Jopolle/INZYNIERKA/README.md

# Repozytorium projektu inżynierskiego

W repozytorium znajdują się wszystkie istotne pliki dotyczące projektu

- Folder HVAC_STM32F7_PCB zawiera schematy projektowanego PCB jak i projekt samej płytki

- Folder dokumentacja zawiera pliki LaTeX pracy inżynierskiej i ostatnią skompilowaną wersję
