Jopolle/INZYNIERKA/dokumentacja/abstract.tex

\begin{abstract}
Praca przedstawia projekt oraz weryfikację stanowiska pomiarowego dla wybranych wielkości fizycznych typowych w systemach HVAC (temperatura, wilgotność, ciśnienie, przepływ oraz sygnały sterujące \SI{0}-\SI{10}{\volt}). Rozwiązanie bazuje na zestawie uruchomieniowym STM32F746G-Discovery z wyświetlaczem TFT oraz na dedykowanej karcie pomiarowo–wyjściowej \SI{0}-\SI{10}{\volt} zaprojektowanej w KiCad. Oprogramowanie wykonano w środowisku Zephyr RTOS z wykorzystaniem sterowników peryferiów i biblioteki LVGL do obsługi interfejsu graficznego.
Przedstawiono wymagania funkcjonalne, projekt części analogowej (tory wejściowe z ochroną i skalowaniem, tor wyjściowy \SI{0}-\SI{10}{\volt}), architekturę oprogramowania (wątki RTOS, kolejki, sterowniki), a także wyniki walidacji dokładności i powtarzalności pomiarów na podstawie wzorców i porównania z przyrządami referencyjnymi. 
\end{abstract}
