Jopolle/INZYNIERKA/dokumentacja/main.tex

\documentclass{pginz}

%%%%%%%%%Miejsce na dodatkowe pakiety%%%%%%%%%%%%%
\usepackage{csquotes}
\usepackage[backend=bibtex,style=numeric,sortcites,sorting=nty,backref,natbib,hyperref]{biblatex}

%\documentclass[a4paper,12pt]{article}

% % Polski język i kodowanie
% \usepackage[utf8]{inputenc}
% \usepackage[T1]{fontenc}
% \usepackage[polish]{babel}

% % Podstawowe pakiety
% \usepackage{amsmath, amssymb}
% \usepackage{graphicx}
% \usepackage{hyperref}
% \usepackage{lmodern}
% \usepackage{csquotes}
% \usepackage{siunitx}
% \DeclareSIUnit{\pixel}{px}
% \usepackage{microtype}
% \usepackage{graphicx}
% \usepackage{float}
% \usepackage{booktabs}
% \usepackage{hyperref}
% \usepackage{geometry}
% \geometry{margin=2.5cm}
% \usepackage[backend=bibtex,style=numeric,sortcites,sorting=nty,backref,natbib,hyperref]{biblatex}

\addbibresource{bibliografia.bib}

\usepackage{minted}
\usepackage{longtable}

\title{Projekt stanowiska pomiarowego podstawowych wielkości fizycznych wykorzystywanych w systemach HVAC
\\\large w oparciu o zestaw STM32F746G-Discovery z wyświetlaczem TFT}
\author{Paweł Bałbatun}
\date{\today}

\begin{document}

\includepdf[pages=-]{StronaTytulowa_193652.pdf}
\tableofcontents

\input{abstract}

\input{intro}
\input{state_of_art}
\input{requirements}
\input{hardware}
\input{firmware}
\input{validation}

\printbibliography
\end{document}
