Jopolle/INZYNIERKA/StronaTytulowa_193652 (1).pdf

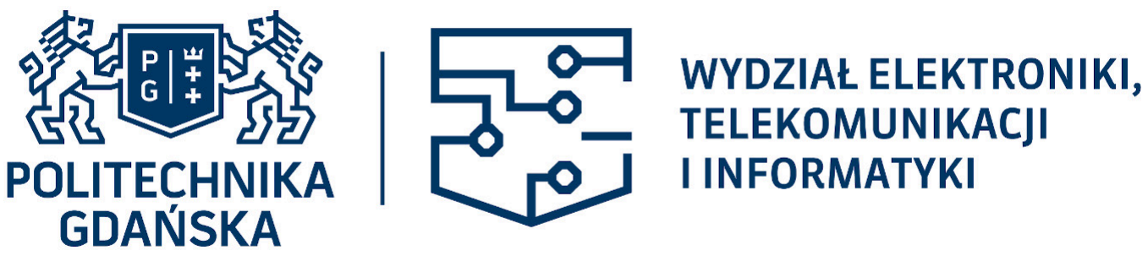
[picture p18: figure]

Imię i nazwisko studenta: Paweł Bałbatun
Nr albumu: 193652
Poziom kształcenia: studia pierwszego stopnia
Forma studiów: stacjonarne
Kierunek studiów: Automatyka, cybernetyka i robotyka Profil: Systemy automatyki

### PROJEKT DYPLOMOWY INŻYNIERSKI

Tytuł projektu w języku polskim: Projekt stanowiska pomiarowego podstawowych wielkości fizycznych wykorzystywanych w systemach HVAC w oparciu o wybrany zestaw uruchomieniowy wyposażony w wyświetlacz graficzny TFT

Tytuł projektu w języku angielskim: Design of a measurement card for a laboratory stand for measuring physical quantities in HVAC systems, based on a selected design kit with a TFT graphic display.

Opiekun pracy: mgr inż. Piotr Darski
