Jopolle/INZYNIERKA/dokumentacja/img/pcb/pcb_zasilanie.png

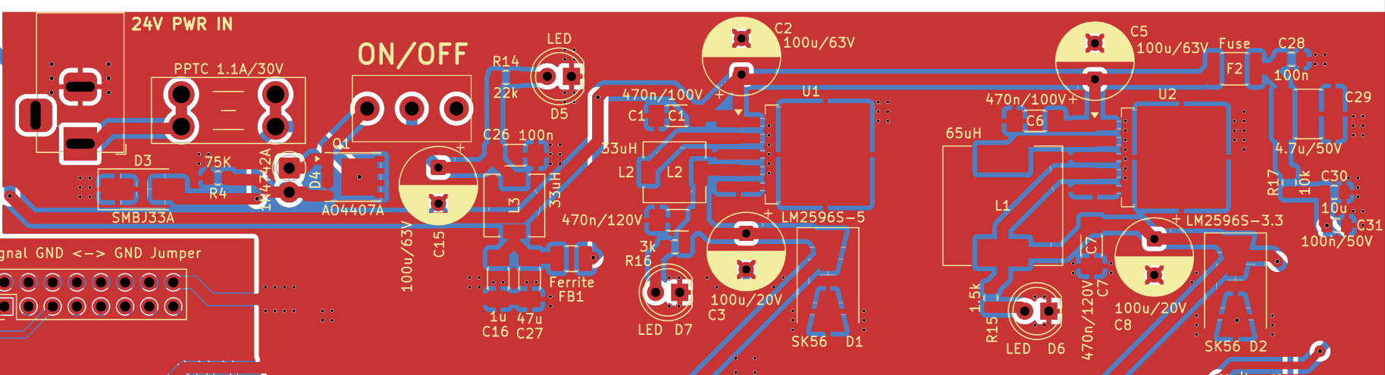
dokumentacja/img/pcb/pcb_zasilanie.png
