Jopolle/INZYNIERKA/dokumentacja/img/pcb/render_empty.png

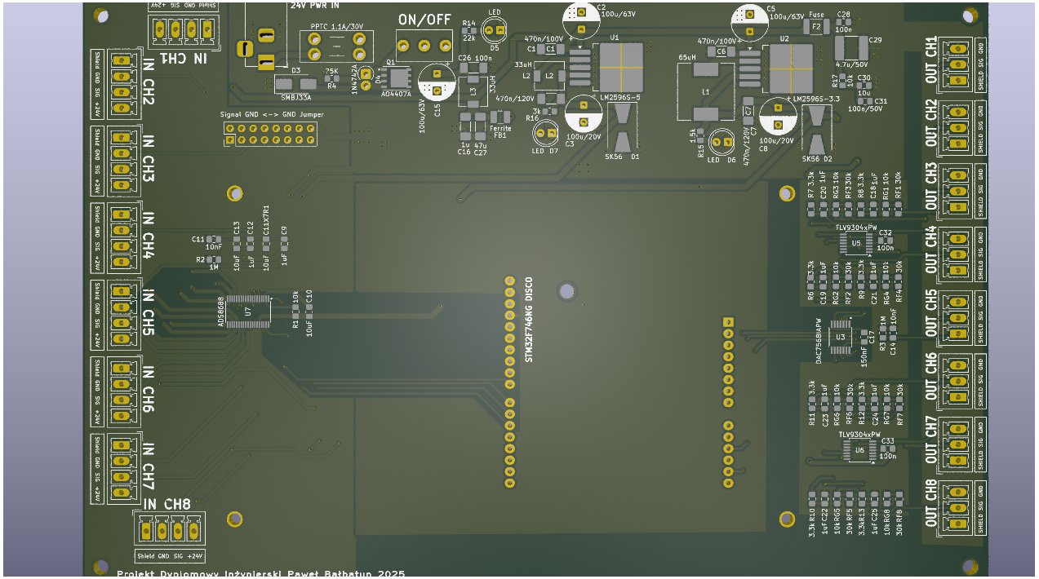
dokumentacja/img/pcb/render_empty.png
