Jopolle/INZYNIERKA/dokumentacja/img/pcb/render_full.png

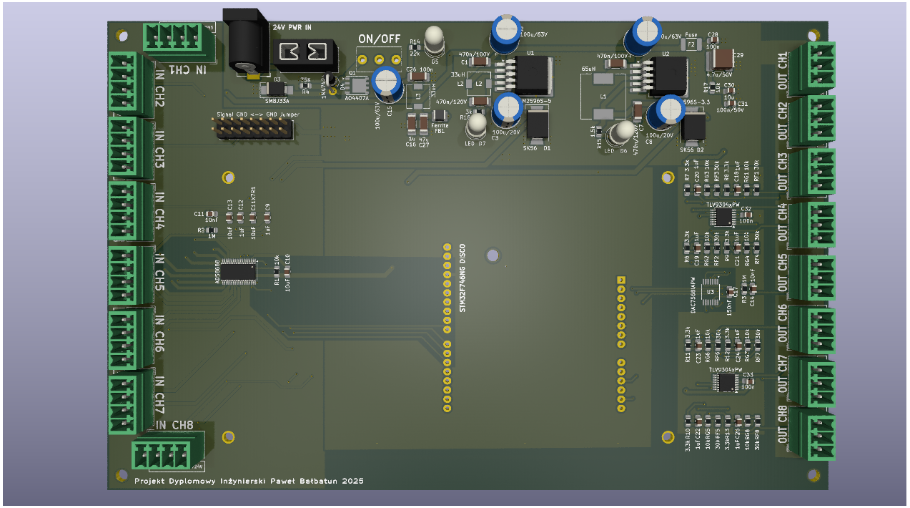
dokumentacja/img/pcb/render_full.png
