Jopolle/INZYNIERKA/HVAC_STM32F7_PCB/HVAC_STM32F7_PCB.jpg

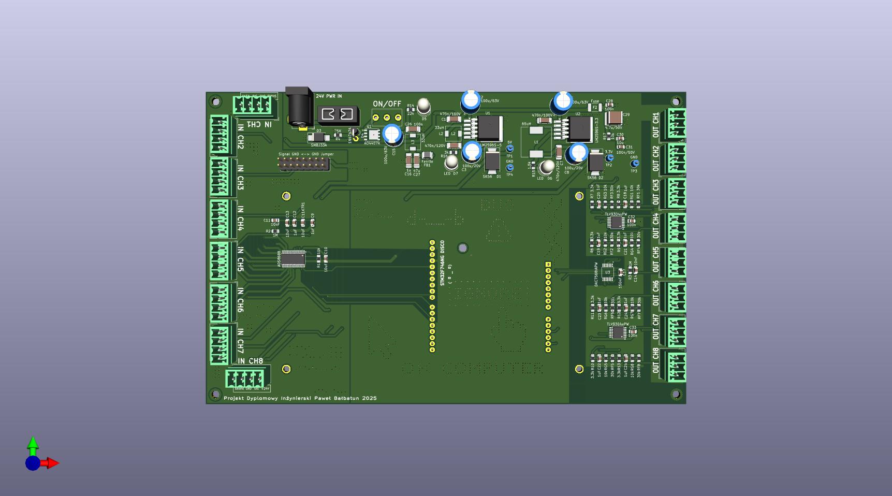
HVAC_STM32F7_PCB/HVAC_STM32F7_PCB.jpg
