Jopolle/INZYNIERKA/dokumentacja/validation.tex

\section{Walidacja}
\subsection{Metodyka}
Źródła wzorcowe (kalibrator napięcia), obciążenie dla wyjścia 0–10 V, środowisko testowe.

\subsection{Wyniki}
Tabele dokładności, histogram odchyleń, niepewność typu A/B, budżet niepewności.

\subsection{Dyskusja}
Ograniczenia, dryft temperaturowy, histereza, propozycje ulepszeń.
