Jopolle/INZYNIERKA/pcb.pdf

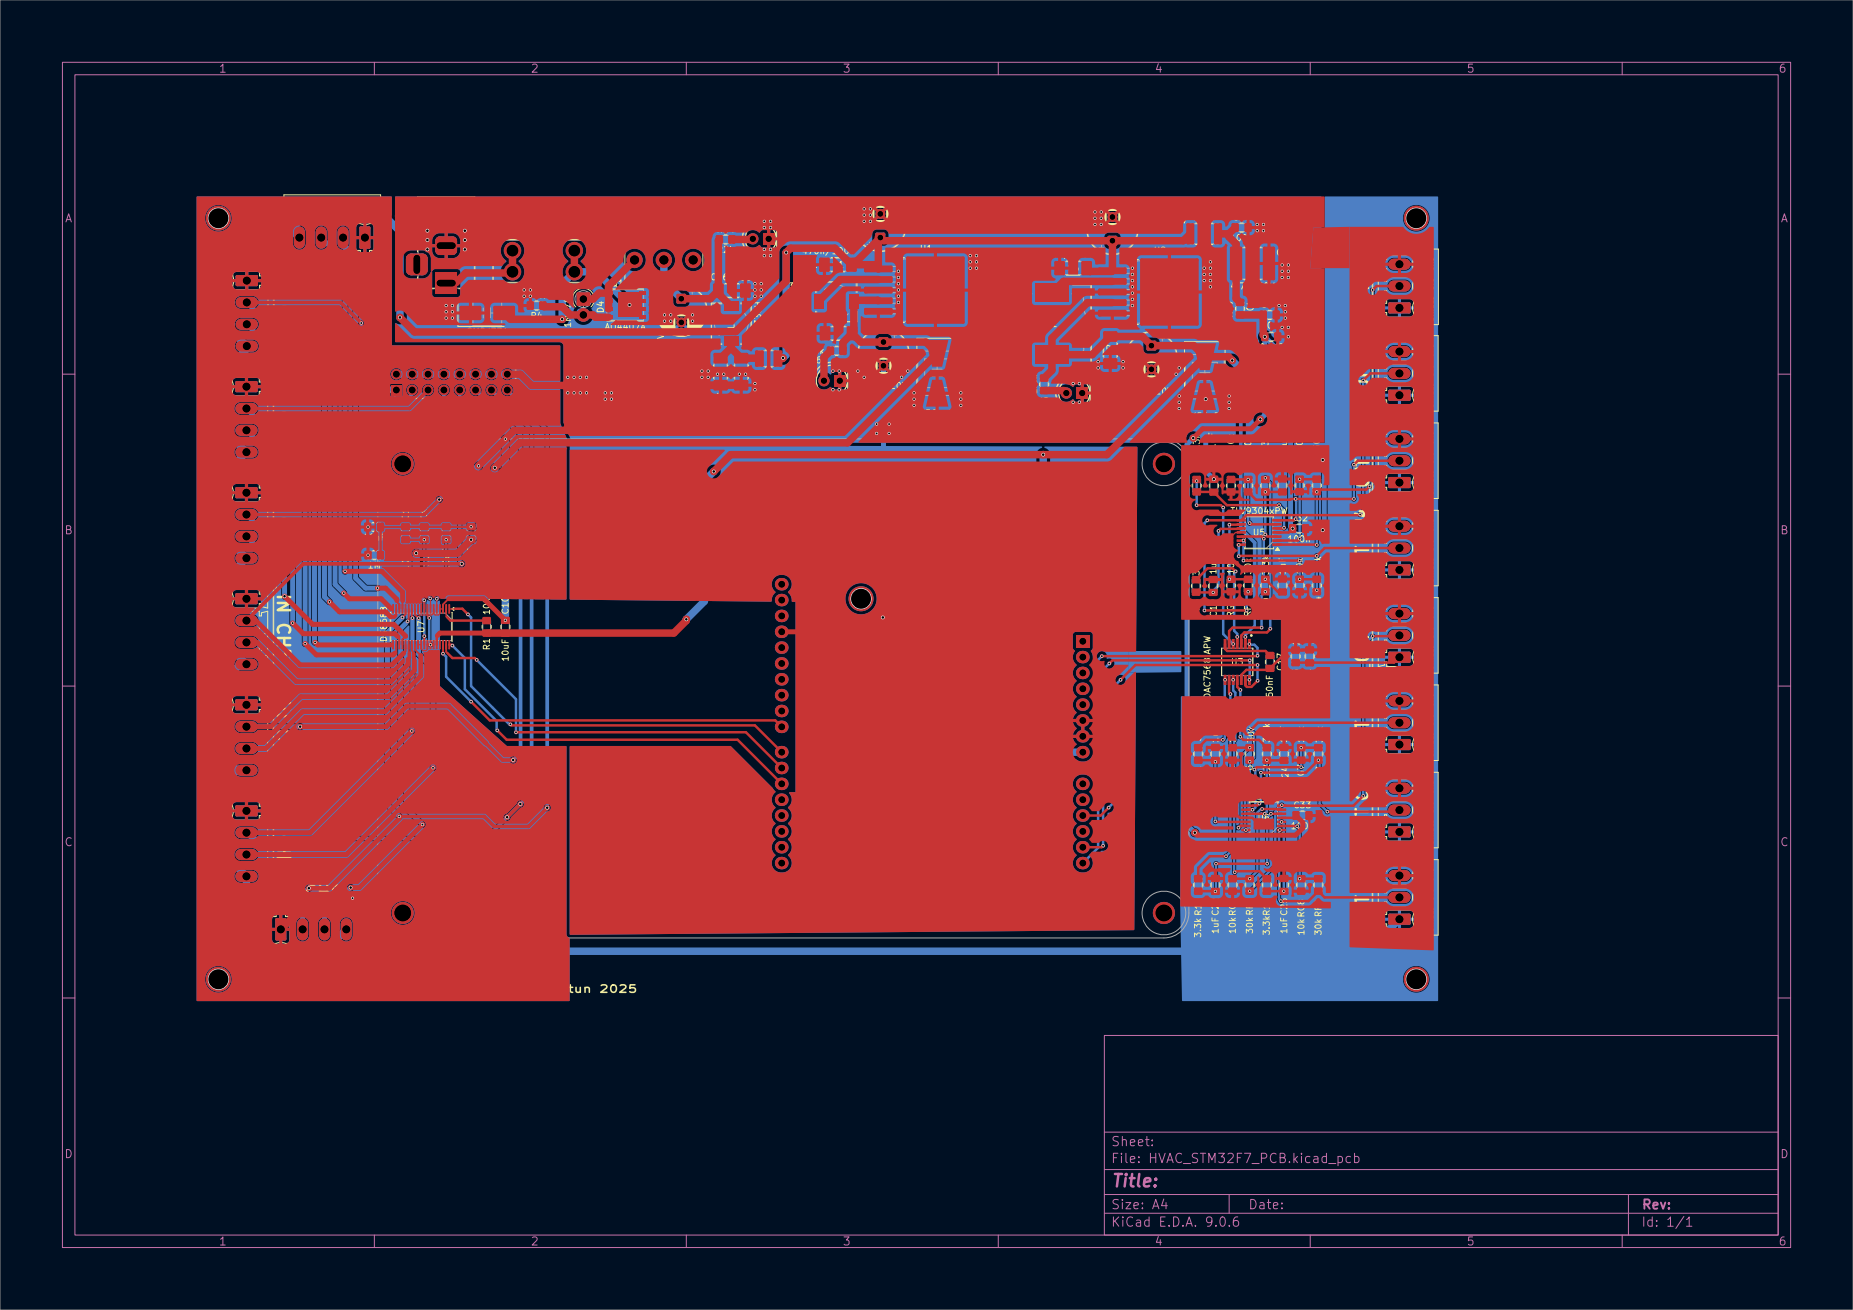
[picture p23: page 1]
