Jopolle/INZYNIERKA/FINALNY/karta_montażowa.pdf

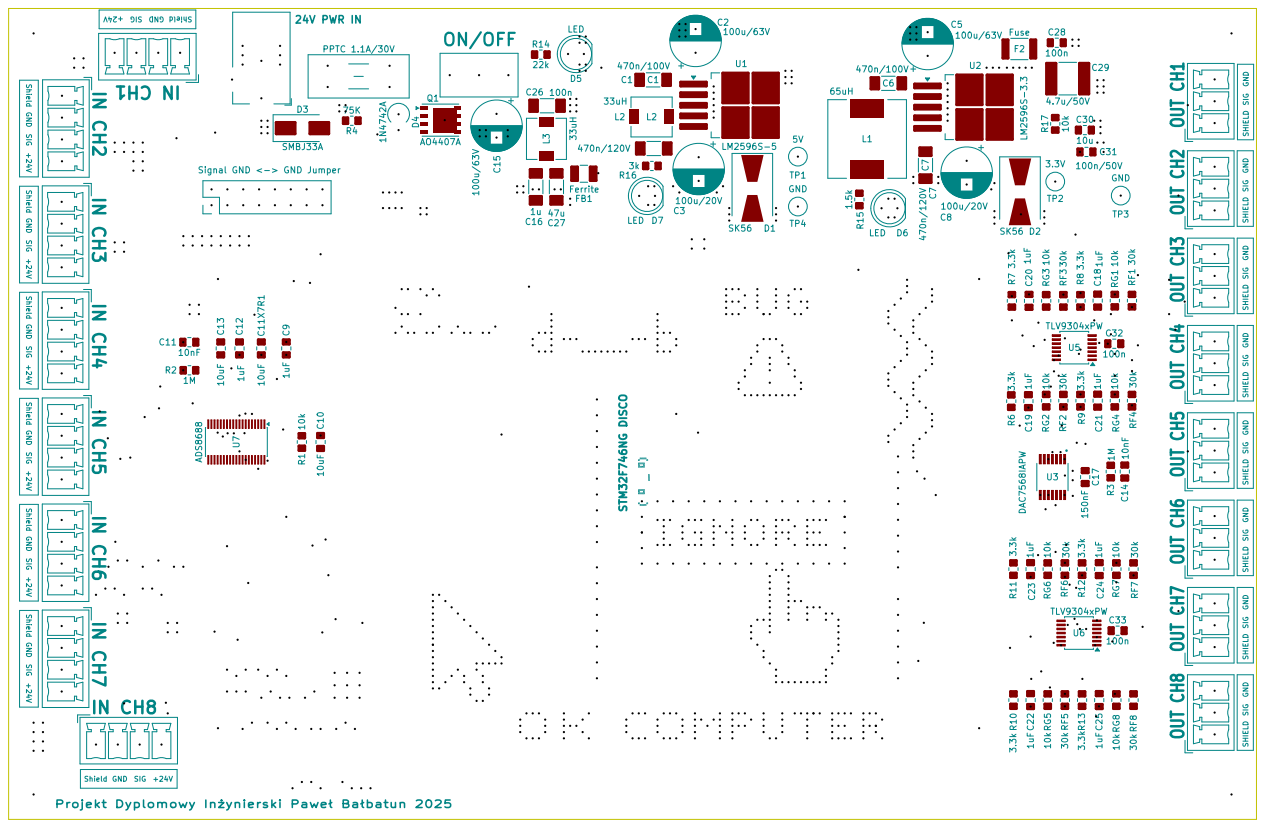
[picture p24: page 1]
