Jopolle/INZYNIERKA/dokumentacja/svg-inkscape/pcb_drawing_svg-raw.pdf

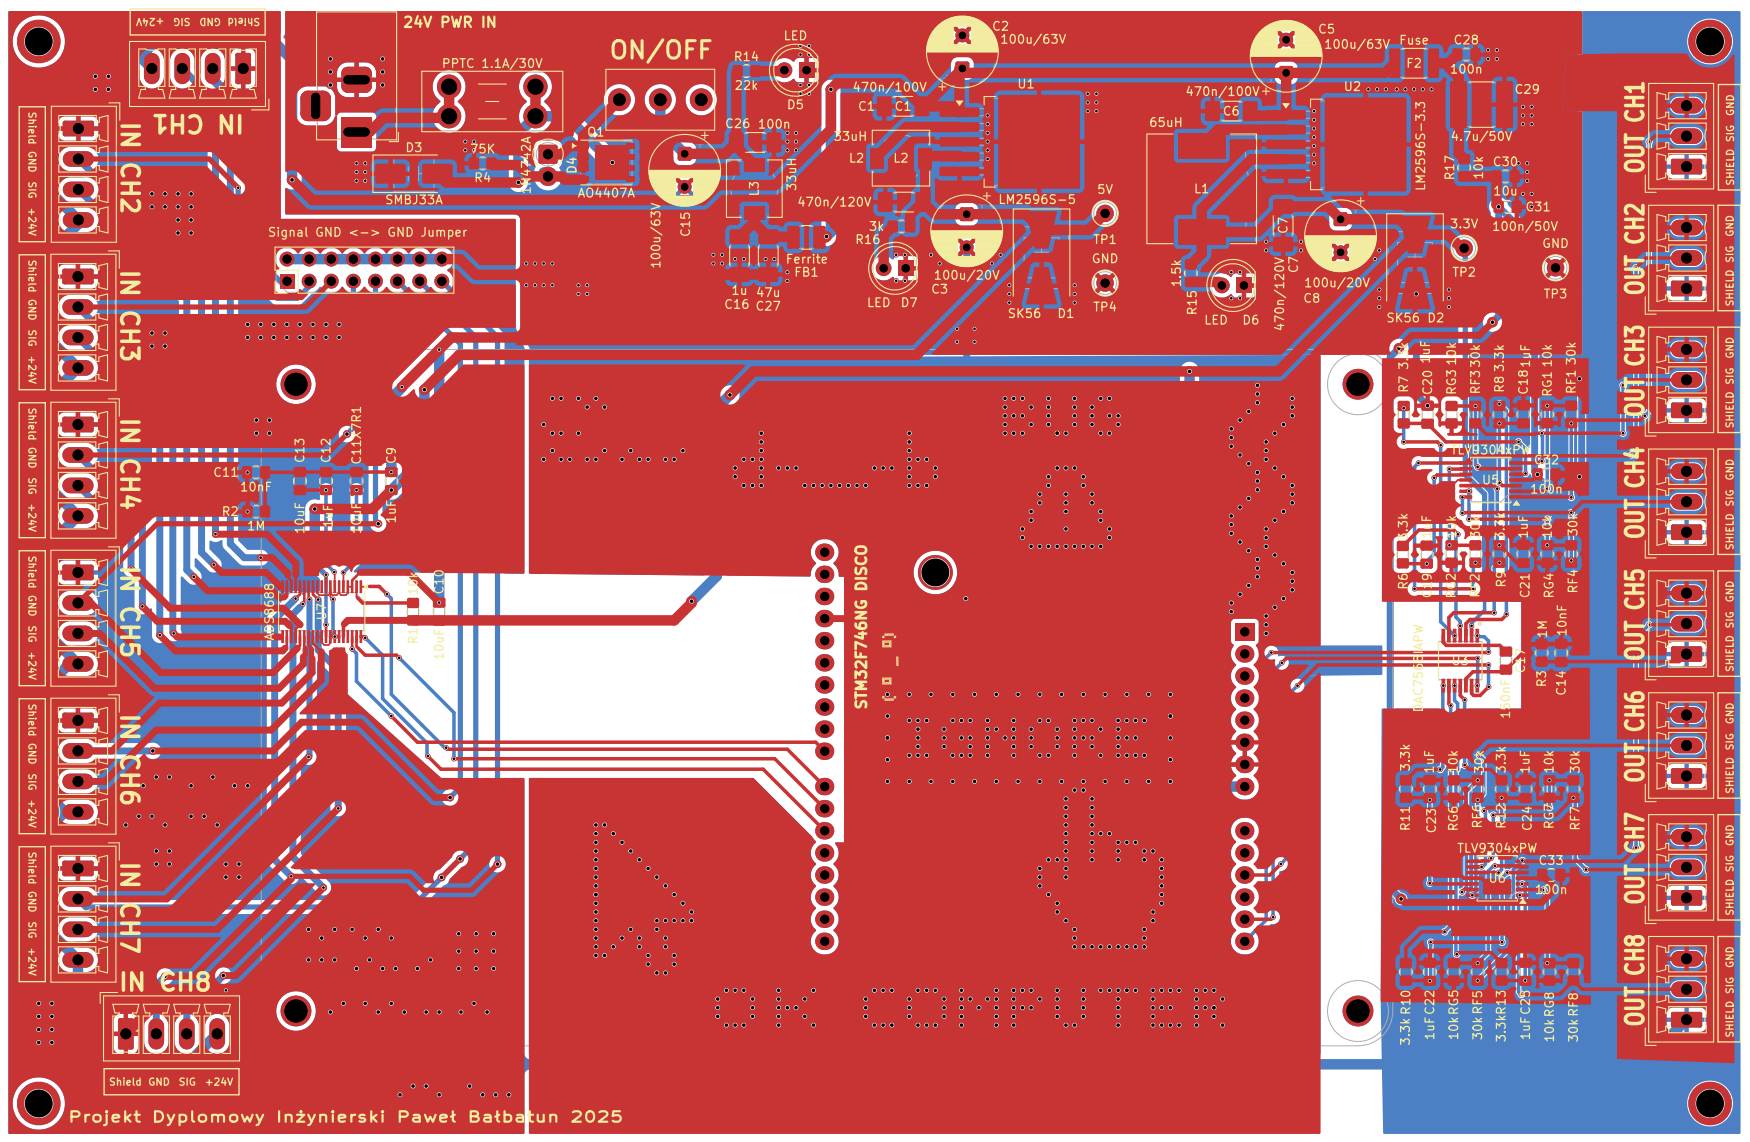
[picture p28: page 1]
