Jopolle/INZYNIERKA/dokumentacja/svg-inkscape/schemat_dac_svg-raw.pdf

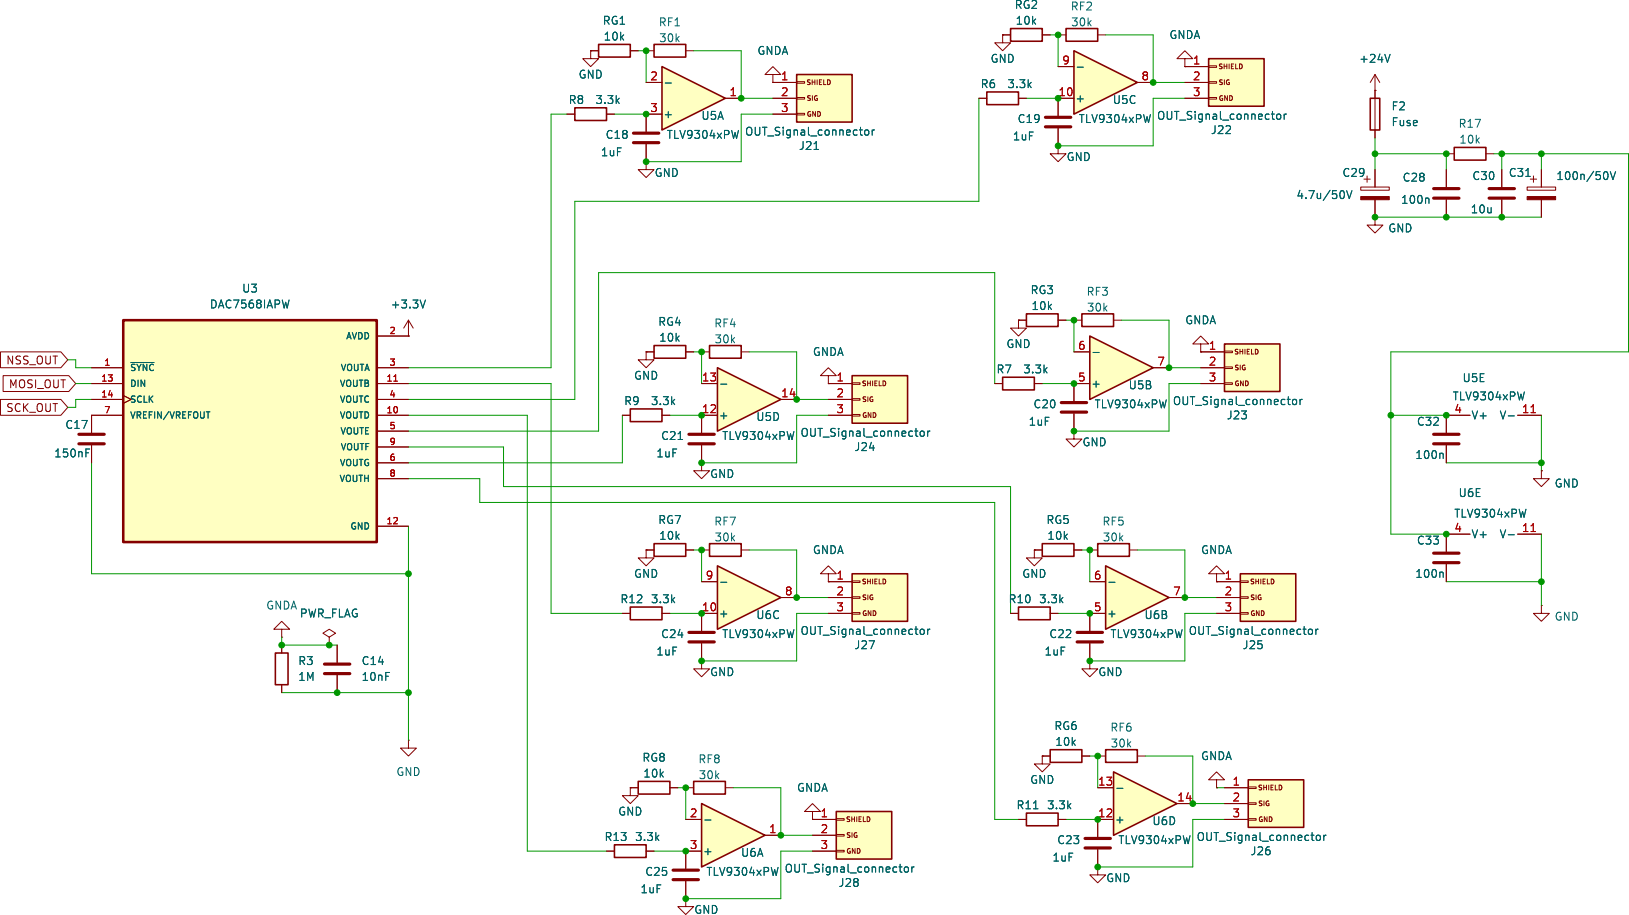
[picture p29: page 1]
