Jopolle/INZYNIERKA/dokumentacja/svg-inkscape/schemat_mcu_svg-raw.pdf

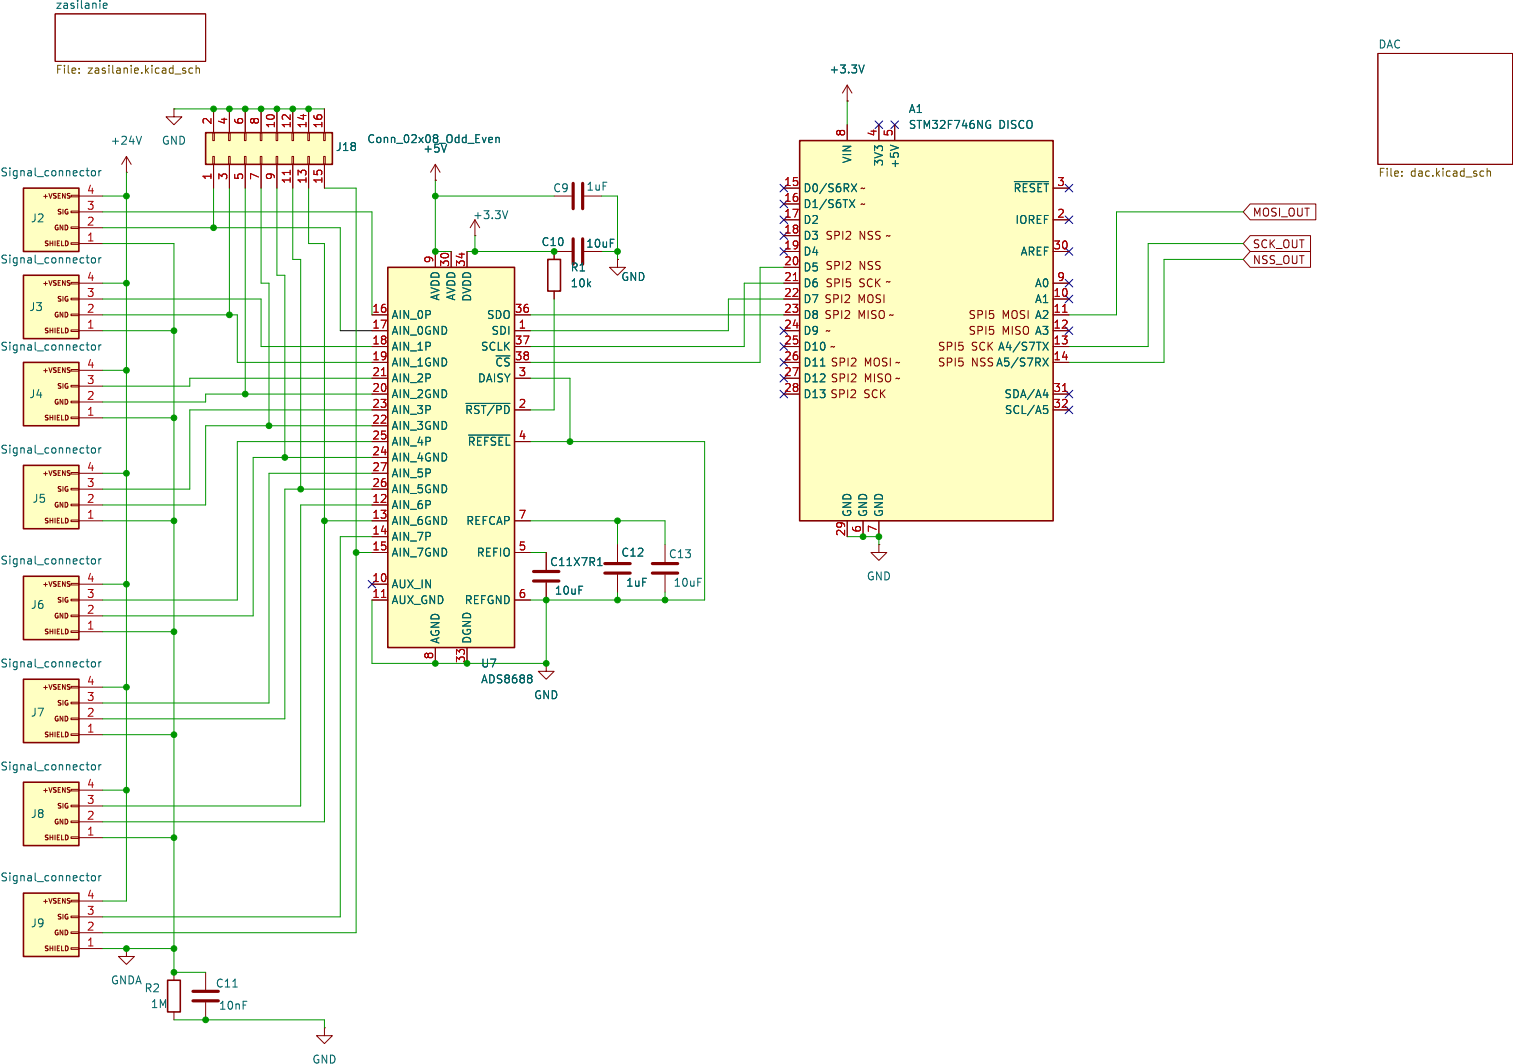
[picture p30: page 1]
