Jopolle/INZYNIERKA/dokumentacja/svg-inkscape/schemat_zasilanie_svg-raw.pdf

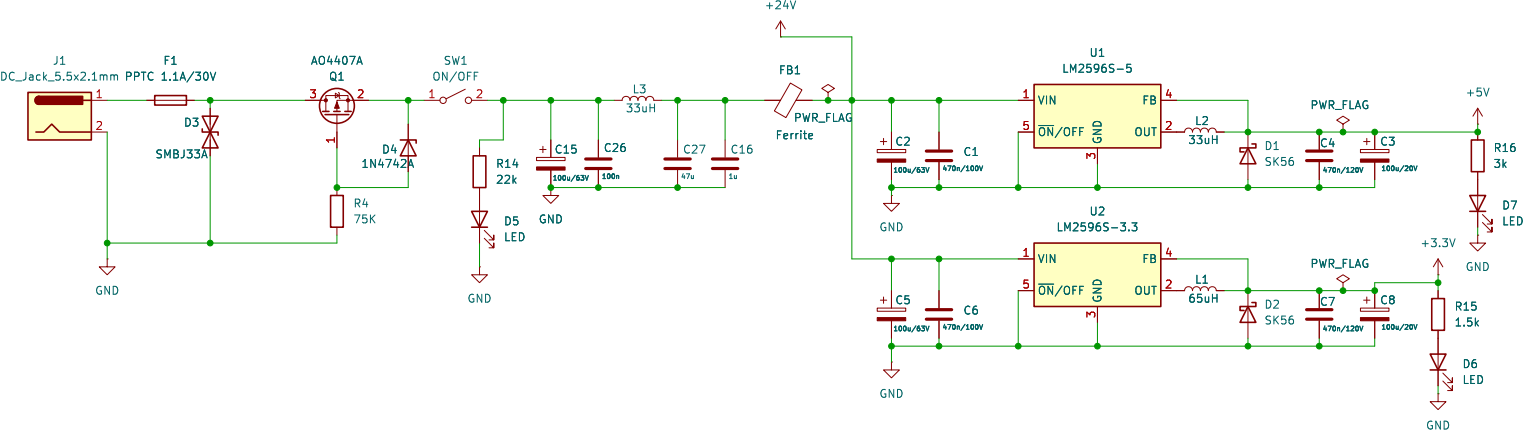
[picture p31: page 1]
