Jopolle/INZYNIERKA/dokumentacja/img/pcb/output.pdf

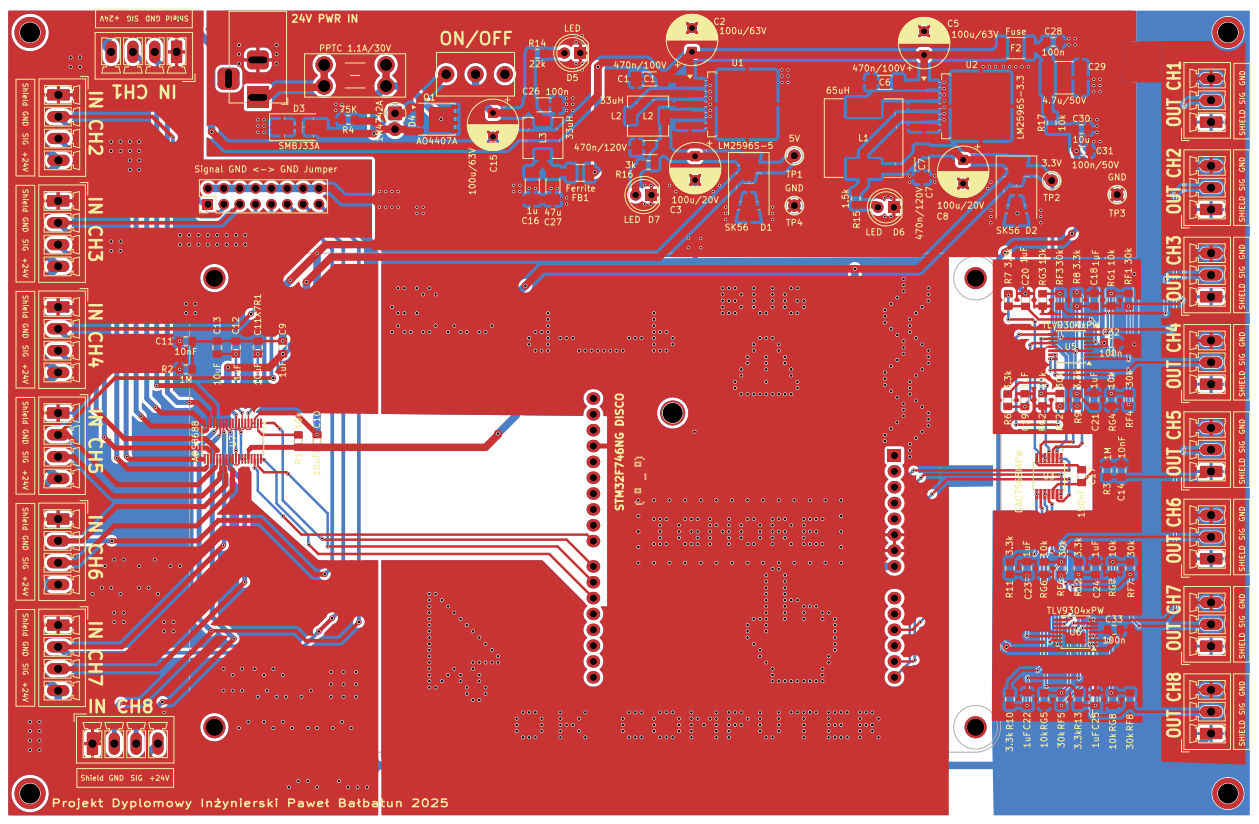
[picture p32: page 1]
