Jopolle/INZYNIERKA/dokumentacja/svg-inkscape_old/pcb_drawing_svg-raw.pdf

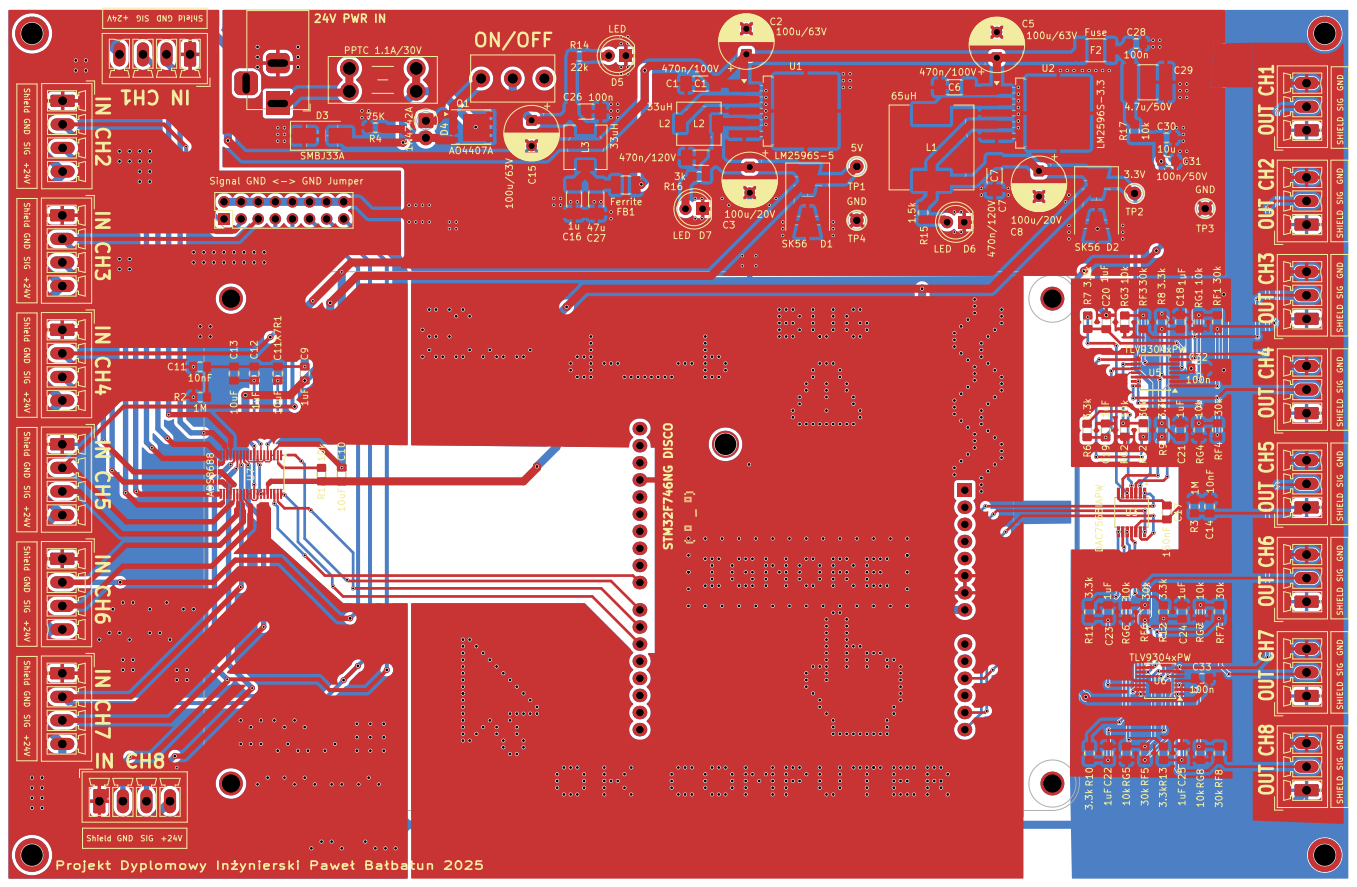
[picture p33: page 1]
