Jopolle/INZYNIERKA/HVAC_STM32F7_PCB/HVAC_STM32F7_PCB.kicad_pcb

## KiCad design HVAC_STM32F7_PCB/HVAC_STM32F7_PCB.kicad_pcb (2025-12-04)

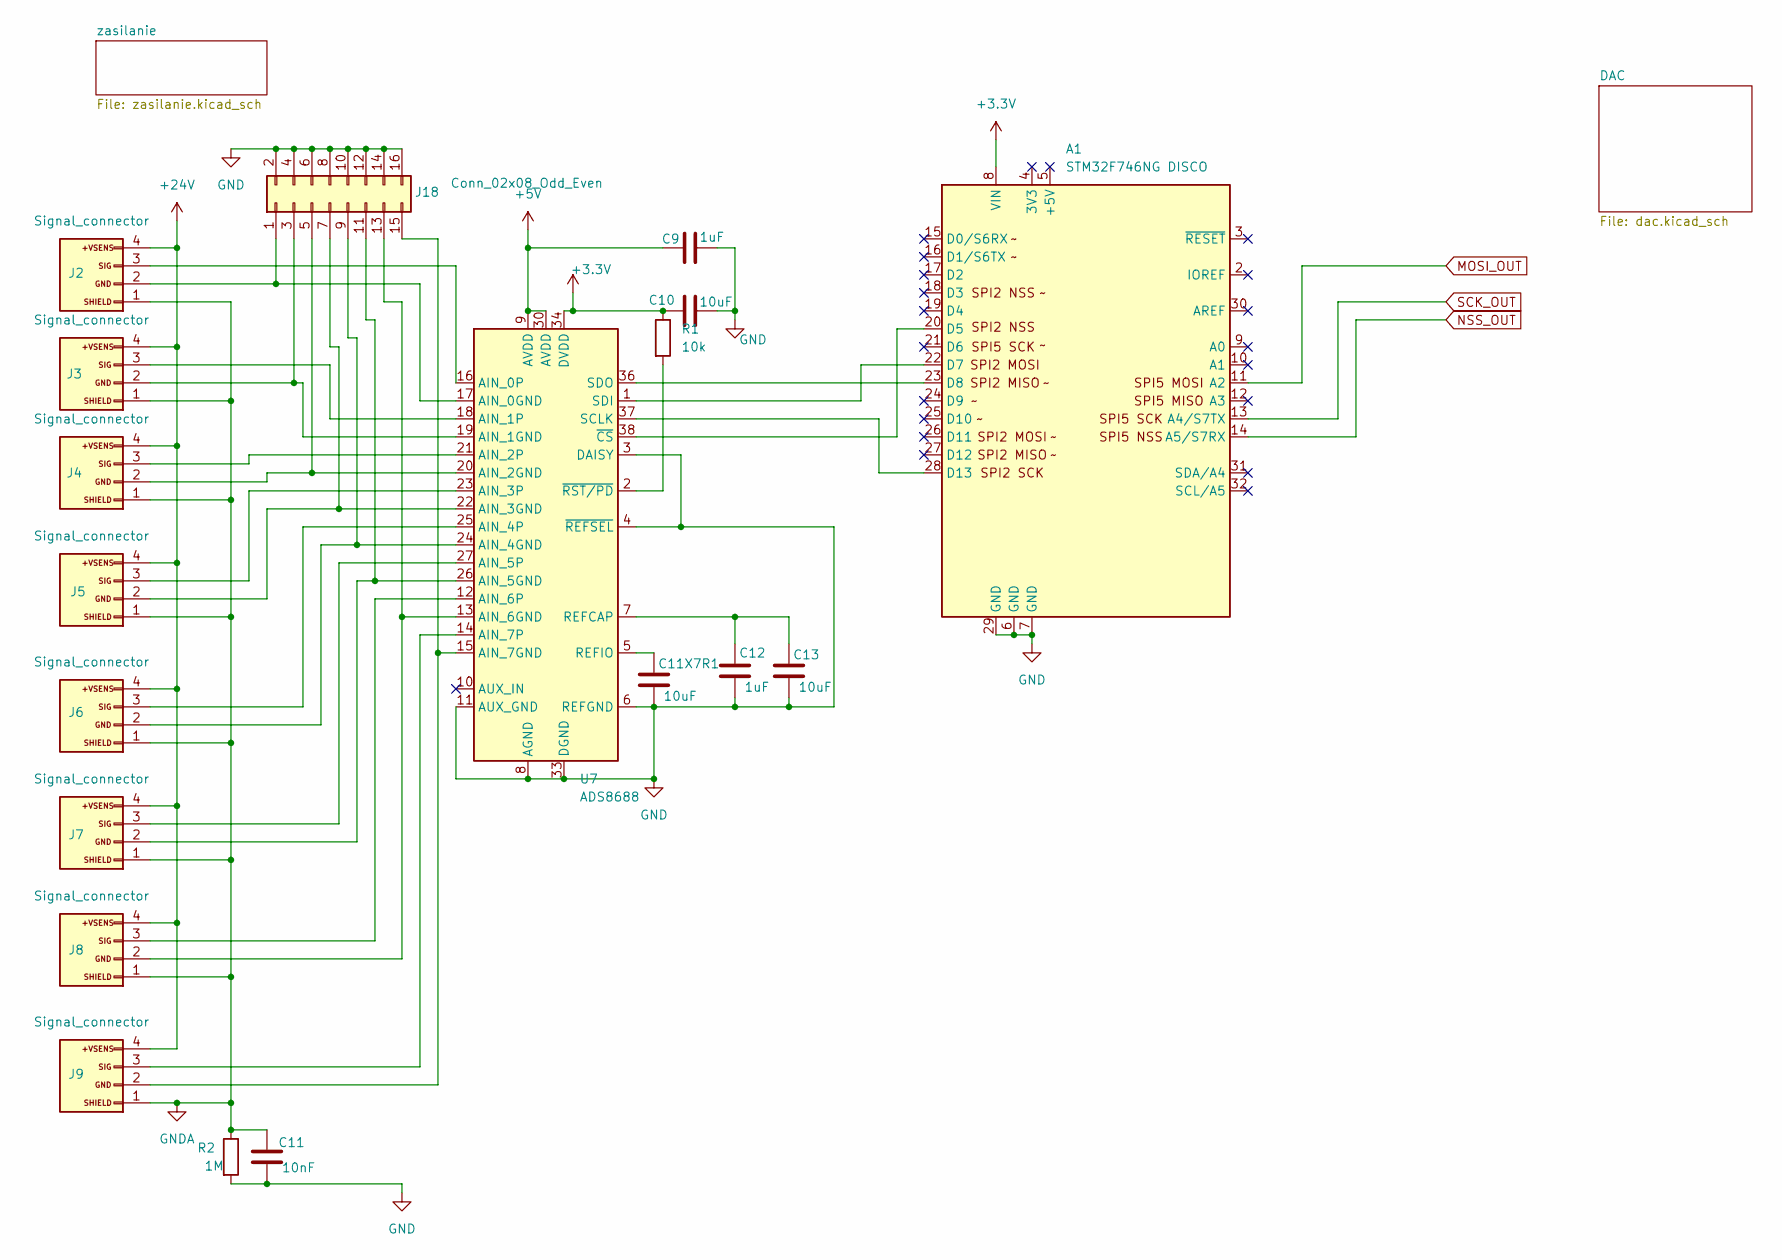
[picture p34: schematic HVAC_STM32F7_PCB.kicad_sch]

Parts:
A1: STM32F746NG DISCO; STM32F7_DISCO
C9, C12: 1uF; C_0805_2012Metric_Pad1.18x1.45mm_HandSolder
C10, C11X7R1, C13: 10uF; C_0805_2012Metric_Pad1.18x1.45mm_HandSolder
C11: 10nF; C_0805_2012Metric_Pad1.18x1.45mm_HandSolder
J2, J3, J4, J5, J6, J7, J8, J9: Signal_connector; PhoenixContact_MCV_1,5_4-G-3.5_1x04_P3.50mm_Vertical
J18: Conn_02x08_Odd_Even; PinHeader_2x08_P2.54mm_Vertical
R1: 10k; R_0805_2012Metric_Pad1.20x1.40mm_HandSolder
R2: 1M; R_0805_2012Metric_Pad1.20x1.40mm_HandSolder
U7: ADS8688; TSSOP-38_4.4x9.7mm_P0.5mm

Connections:
+3.3V: A1.8 (VIN), C10.1, R1.1, U7.34 (DVDD); also elsewhere on the board
+5V: C9.2, U7.9 (AVDD), U7.30 (AVDD); also elsewhere on the board
+24V: J2.4 (+VSENS), J3.4 (+VSENS), J4.4 (+VSENS), J5.4 (+VSENS), J6.4 (+VSENS), J7.4 (+VSENS), J8.4 (+VSENS), J9.4 (+VSENS); also elsewhere on the board
GND: A1.6 (GND), A1.7 (GND), A1.29 (GND), C9.1, C10.2, C11.2, C11X7R1.2, C12.2, C13.2, J18.2, J18.4, J18.6, J18.8, J18.10, J18.12, J18.14, J18.16, R2.2, U7.3 (DAISY), U7.4 (~REFSEL), U7.6 (REFGND), U7.8 (AGND), U7.11 (AUX_GND), U7.28 (AGND), U7.29 (AGND), U7.31 (AGND), U7.32 (AGND), U7.33 (DGND); also elsewhere on the board
GNDA: C11.1, J2.1 (SHIELD), J3.1 (SHIELD), J4.1 (SHIELD), J5.1 (SHIELD), J6.1 (SHIELD), J7.1 (SHIELD), J8.1 (SHIELD), J9.1 (SHIELD), R2.1; also elsewhere on the board
MOSI_OUT: A1.11 (A2); also elsewhere on the board
NSS_OUT: A1.14 (A5/S7RX); also elsewhere on the board
unnamed: A1.20 (D5), U7.38 (~CS)
unnamed: A1.22 (D7), U7.1 (SDI)
unnamed: A1.23 (D8), U7.36 (SDO)
unnamed: A1.28 (D13), U7.37 (SCLK)
unnamed: J2.3 (SIG), U7.16 (AIN_0P)
unnamed: J3.3 (SIG), U7.18 (AIN_1P)
unnamed: J4.3 (SIG), U7.21 (AIN_2P)
unnamed: J5.3 (SIG), U7.23 (AIN_3P)
unnamed: J6.3 (SIG), U7.25 (AIN_4P)
unnamed: J7.3 (SIG), U7.27 (AIN_5P)
unnamed: J8.3 (SIG), U7.12 (AIN_6P)
unnamed: J9.3 (SIG), U7.14 (AIN_7P)
unnamed: J2.2 (GND), J18.1, U7.17 (AIN_0GND)
unnamed: J3.2 (GND), J18.3, U7.19 (AIN_1GND)
unnamed: J4.2 (GND), J18.5, U7.20 (AIN_2GND)
unnamed: J5.2 (GND), J18.7, U7.22 (AIN_3GND)
unnamed: J6.2 (GND), J18.9, U7.24 (AIN_4GND)
unnamed: J7.2 (GND), J18.11, U7.26 (AIN_5GND)
unnamed: J8.2 (GND), J18.13, U7.13 (AIN_6GND)
unnamed: J9.2 (GND), J18.15, U7.15 (AIN_7GND)
unnamed: C12.1, C13.1, U7.7 (REFCAP)
unnamed: C11X7R1.1, U7.5 (REFIO)
unnamed: R1.2, U7.2 (~RST/PD)
SCK_OUT: A1.13 (A4/S7TX); also elsewhere on the board

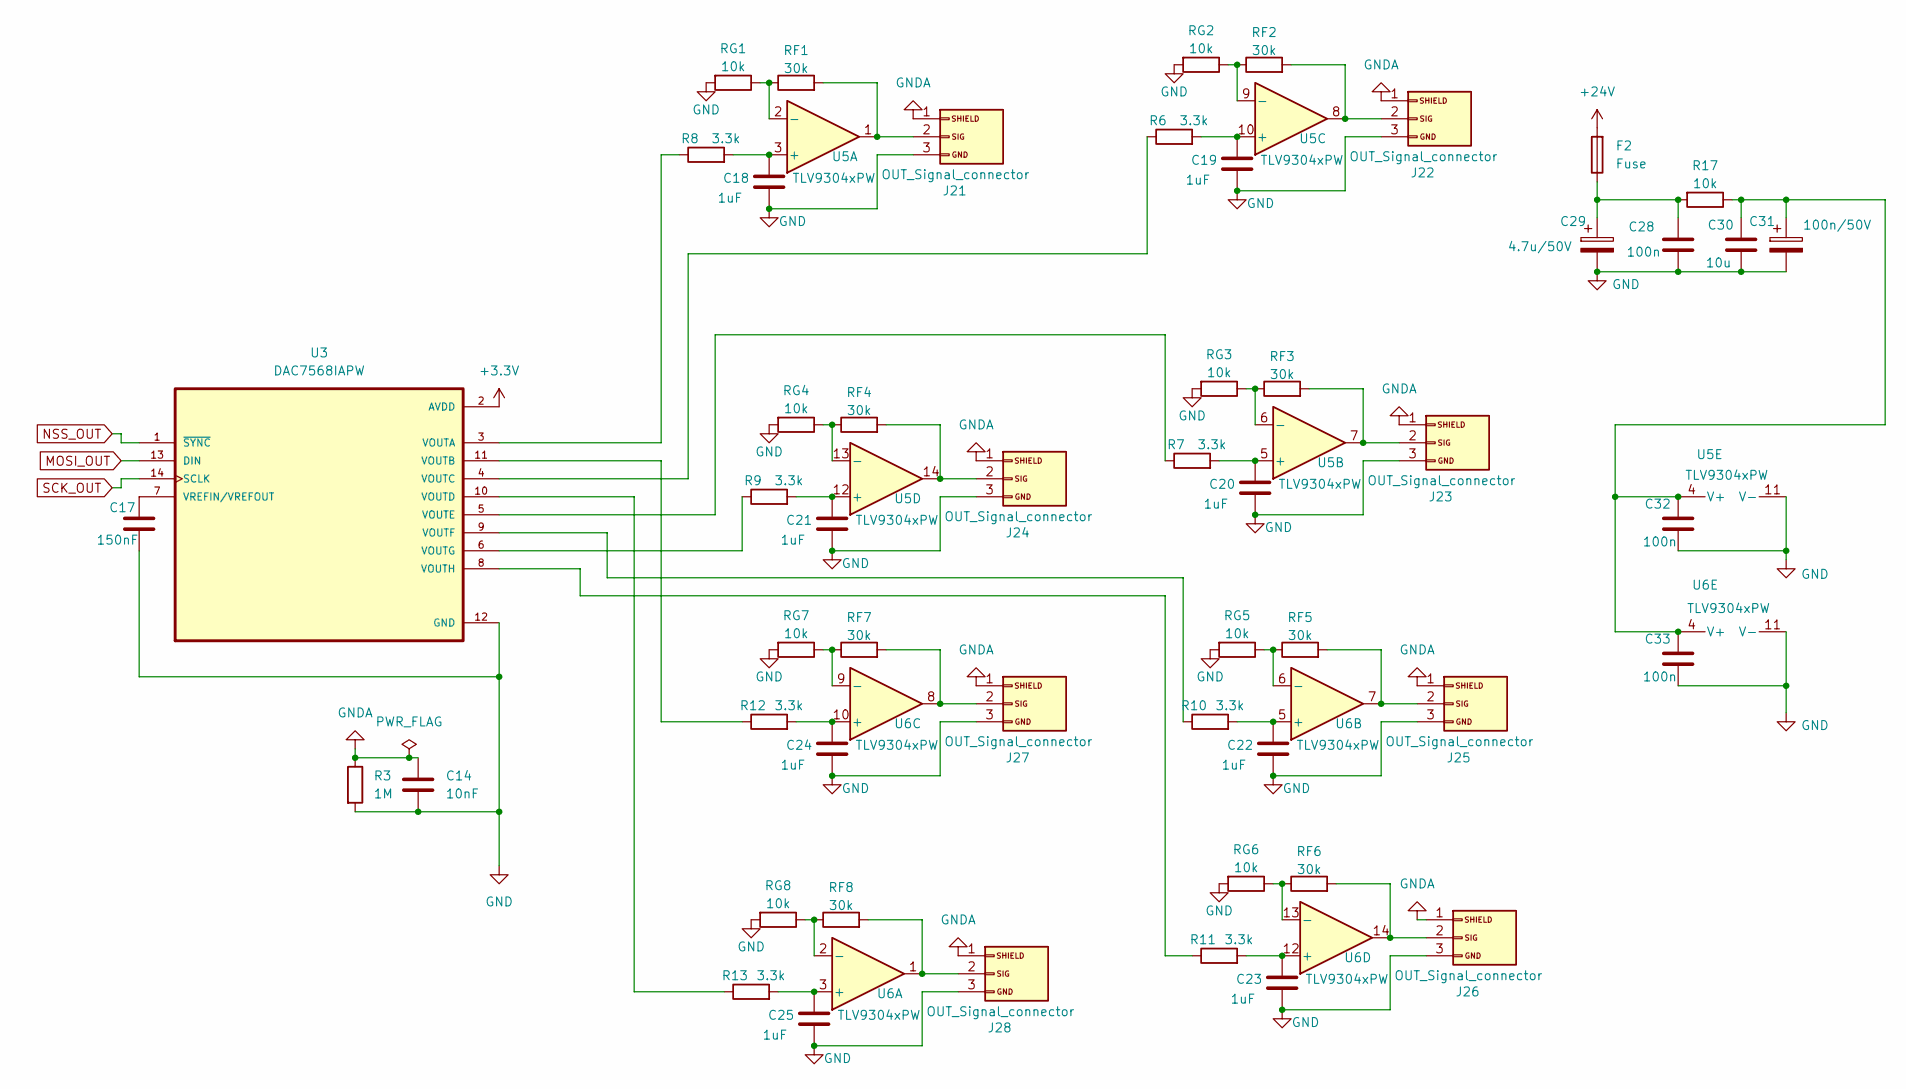
[picture p35: schematic dac.kicad_sch]

Parts:
C14: 10nF; C_0805_2012Metric_Pad1.18x1.45mm_HandSolder
C17: 150nF; C_0805_2012Metric_Pad1.18x1.45mm_HandSolder
C18, C19, C20, C21, C22, C23, C24, C25: 1uF; C_0805_2012Metric_Pad1.18x1.45mm_HandSolder
C28, C32, C33: 100n; C_0805_2012Metric_Pad1.18x1.45mm_HandSolder
C29: 4.7u/50V; C_2220_5750Metric_Pad1.97x5.40mm_HandSolder
C30: 10u; C_0805_2012Metric_Pad1.18x1.45mm_HandSolder
C31: 100n/50V; C_0805_2012Metric_Pad1.18x1.45mm_HandSolder
F2: Fuse; Fuse_1812_4532Metric_Pad1.30x3.40mm_HandSolder
J21, J22, J23, J24, J25, J26, J27, J28: OUT_Signal_connector; PhoenixContact_MCV_1,5_3-G-3.5_1x03_P3.50mm_Vertical
R3: 1M; R_0805_2012Metric_Pad1.20x1.40mm_HandSolder
R6, R7, R8, R9, R10, R11, R12, R13: 3.3k; R_0805_2012Metric_Pad1.20x1.40mm_HandSolder
R17: 10k; R_0805_2012Metric_Pad1.20x1.40mm_HandSolder
RF1, RF2, RF3, RF4, RF5, RF6, RF7, RF8: 30k; R_0805_2012Metric_Pad1.20x1.40mm_HandSolder
RG1, RG2, RG3, RG4, RG5, RG6, RG7, RG8: 10k; R_0805_2012Metric_Pad1.20x1.40mm_HandSolder
U3: DAC7568IAPW; dac
U5, U6: TLV9304xPW; TSSOP-14_4.4x5mm_P0.65mm

Connections:
+3.3V: U3.2 (AVDD); also elsewhere on the board
+24V: F2.2; also elsewhere on the board
GND: C14.2, C17.2, C18.2, C19.2, C20.2, C21.2, C22.2, C23.2, C24.2, C25.2, C28.2, C29.2, C30.2, C31.2, C32.2, C33.2, J21.3 (SIG), J22.3 (SIG), J23.3 (SIG), J24.3 (SIG), J25.3 (SIG), J26.3 (SIG), J27.3 (SIG), J28.3 (SIG), R3.2, RG1.2, RG2.2, RG3.2, RG4.2, RG5.2, RG6.2, RG7.2, RG8.2, U3.12 (GND), U5.11 (V-), U6.11 (V-); also elsewhere on the board
GNDA: C14.1, J21.1 (SHIELD), J22.1 (SHIELD), J23.1 (SHIELD), J24.1 (SHIELD), J25.1 (SHIELD), J26.1 (SHIELD), J27.1 (SHIELD), J28.1 (SHIELD), R3.1; also elsewhere on the board
MOSI_OUT: U3.13 (DIN); also elsewhere on the board
NSS_OUT: U3.1 (~SYNC); also elsewhere on the board
unnamed: C28.1, C29.1, F2.1, R17.2
unnamed: J21.2 (GND), RF1.2, U5.1
unnamed: J22.2 (GND), RF2.2, U5.8
unnamed: J23.2 (GND), RF3.2, U5.7
unnamed: J24.2 (GND), RF4.2, U5.14
unnamed: J25.2 (GND), RF5.2, U6.7
unnamed: J26.2 (GND), RF6.2, U6.14
unnamed: J27.2 (GND), RF7.2, U6.8
unnamed: J28.2 (GND), RF8.2, U6.1
unnamed: R8.1, U3.3 (VOUTA)
unnamed: R12.1, U3.11 (VOUTB)
unnamed: R6.1, U3.4 (VOUTC)
unnamed: R13.1, U3.10 (VOUTD)
unnamed: R7.1, U3.5 (VOUTE)
unnamed: R10.1, U3.9 (VOUTF)
unnamed: R9.1, U3.6 (VOUTG)
unnamed: R11.1, U3.8 (VOUTH)
unnamed: C17.1, U3.7 (VREFIN/VREFOUT)
unnamed: C18.1, R8.2, U5.3 (+)
unnamed: RF1.1, RG1.1, U5.2 (-)
unnamed: C20.1, R7.2, U5.5 (+)
unnamed: RF3.1, RG3.1, U5.6 (-)
unnamed: C19.1, R6.2, U5.10 (+)
unnamed: RF2.1, RG2.1, U5.9 (-)
unnamed: C21.1, R9.2, U5.12 (+)
unnamed: RF4.1, RG4.1, U5.13 (-)
unnamed: C30.1, C31.1, C32.1, C33.1, R17.1, U5.4 (V+), U6.4 (V+)
unnamed: C25.1, R13.2, U6.3 (+)
unnamed: RF8.1, RG8.1, U6.2 (-)
unnamed: C22.1, R10.2, U6.5 (+)
unnamed: RF5.1, RG5.1, U6.6 (-)
unnamed: C24.1, R12.2, U6.10 (+)
unnamed: RF7.1, RG7.1, U6.9 (-)
unnamed: C23.1, R11.2, U6.12 (+)
unnamed: RF6.1, RG6.1, U6.13 (-)
SCK_OUT: U3.14 (SCLK); also elsewhere on the board

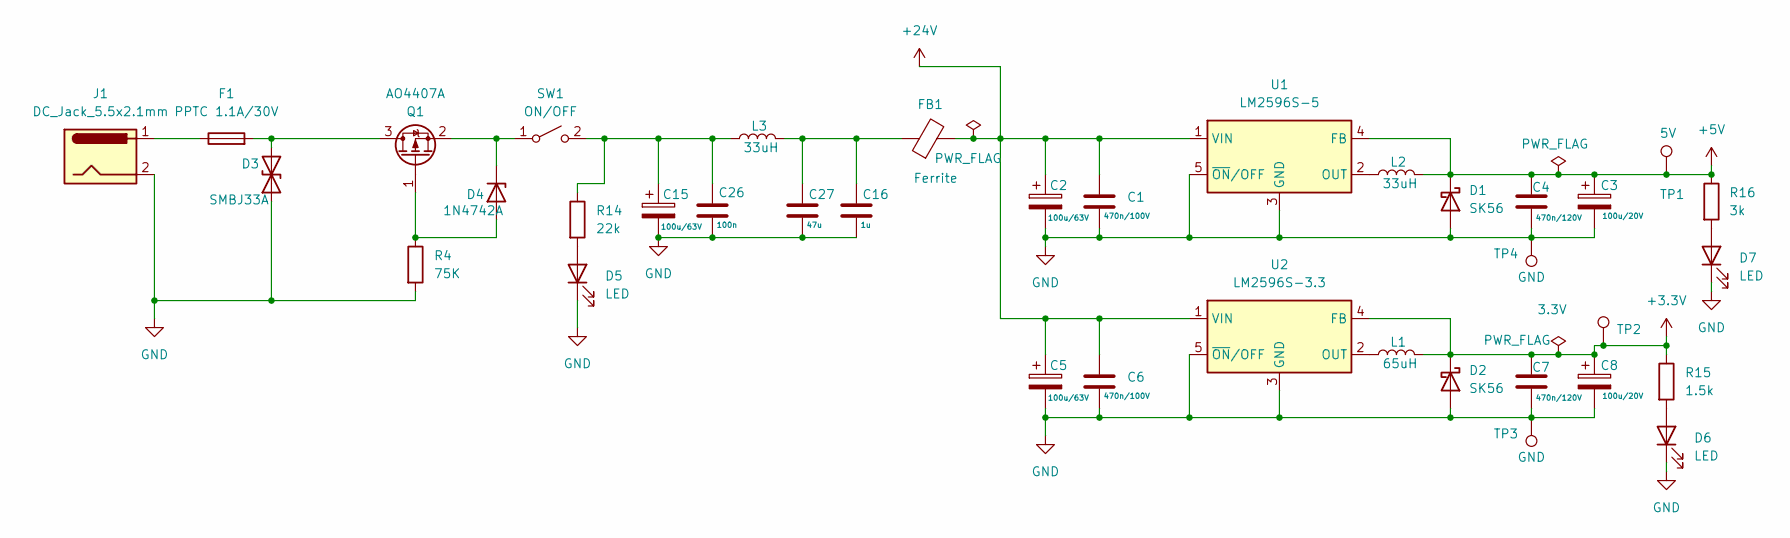
[picture p36: schematic zasilanie.kicad_sch]

Parts:
C1, C6: 470n/100V; C_1808_4520Metric_Pad1.72x2.30mm_HandSolder
C2, C5, C15: 100u/63V; CP_Radial_D8.0mm_P3.80mm
C3, C8: 100u/20V; CP_Radial_D8.0mm_P3.80mm
C4, C7: 470n/120V; C_1808_4520Metric_Pad1.72x2.30mm_HandSolder
C16: 1u; C_1808_4520Metric_Pad1.72x2.30mm_HandSolder
C26: 100n; C_1808_4520Metric_Pad1.72x2.30mm_HandSolder
C27: 47u; C_1808_4520Metric_Pad1.72x2.30mm_HandSolder
D1, D2: SK56; D_SMB-SMC_Universal_Handsoldering
D3: SMBJ33A; D_SMB_Handsoldering
D4: 1N4742A; D_DO-41_SOD81_P2.54mm_Vertical_AnodeUp
D5, D6, D7: LED; LED_D5.0mm_Clear
F1: PPTC 1.1A/30V; Fuseholder_Blade_Mini_Keystone_3568
FB1: Ferrite; L_1210_3225Metric_Pad1.42x2.65mm_HandSolder
J1: DC_Jack_5.5x2.1mm; BarrelJack_Horizontal
L1: 65uH; L_12x12mm_H4.5mm
L2, L3: 33uH; L_6.3x6.3_H3
Q1: AO4407A; PowerPAK_SO-8_Single
R4: 75K; R_0805_2012Metric_Pad1.20x1.40mm_HandSolder
R14: 22k; R_0805_2012Metric_Pad1.20x1.40mm_HandSolder
R15: 1.5k; R_0805_2012Metric_Pad1.20x1.40mm_HandSolder
R16: 3k; R_0805_2012Metric_Pad1.20x1.40mm_HandSolder
SW1: ON/OFF; SLW-1276864-4A-D_FOOTPRINT
TP1: 5V; TestPoint_Loop_D1.80mm_Drill1.0mm_Beaded
TP2: 3.3V; TestPoint_Loop_D1.80mm_Drill1.0mm_Beaded
TP3, TP4: GND; TestPoint_Loop_D1.80mm_Drill1.0mm_Beaded
U1: LM2596S-5; TO-263-5_TabPin3
U2: LM2596S-3.3; TO-263-5_TabPin3

Connections:
+3.3V: C7.1, C8.1, D2.1 (K), L1.2, R15.1, TP2.1, U2.4 (FB); also elsewhere on the board
+5V: C3.1, C4.1, D1.1 (K), L2.2, R16.1, TP1.1, U1.4 (FB); also elsewhere on the board
+24V: C1.1, C2.1, C5.1, C6.1, FB1.2, U1.1 (VIN), U2.1 (VIN); also elsewhere on the board
GND: C1.2, C2.2, C3.2, C4.2, C5.2, C6.2, C7.2, C8.2, C15.2, C16.2, C26.2, C27.2, D1.2 (A), D2.2 (A), D3.1 (A1), D5.1 (K), D6.1 (K), D7.1 (K), J1.2, R4.2, TP3.1, TP4.1, U1.3 (GND), U1.5 (~ON/OFF), U2.3 (GND), U2.5 (~ON/OFF); also elsewhere on the board
unnamed: C16.1, C27.1, FB1.1, L3.2
unnamed: D3.2 (A2), F1.2, Q1.3 (D)
unnamed: D4.2 (A), Q1.1 (G), R4.1
unnamed: D4.1 (K), Q1.2 (S), SW1.1 (A)
unnamed: D5.2 (A), R14.2
unnamed: D6.2 (A), R15.2
unnamed: D7.2 (A), R16.2
unnamed: F1.1, J1.1
unnamed: C15.1, C26.1, L3.1, R14.1, SW1.2 (B)
unnamed: L2.1, U1.2 (OUT)
unnamed: L1.1, U2.2 (OUT)

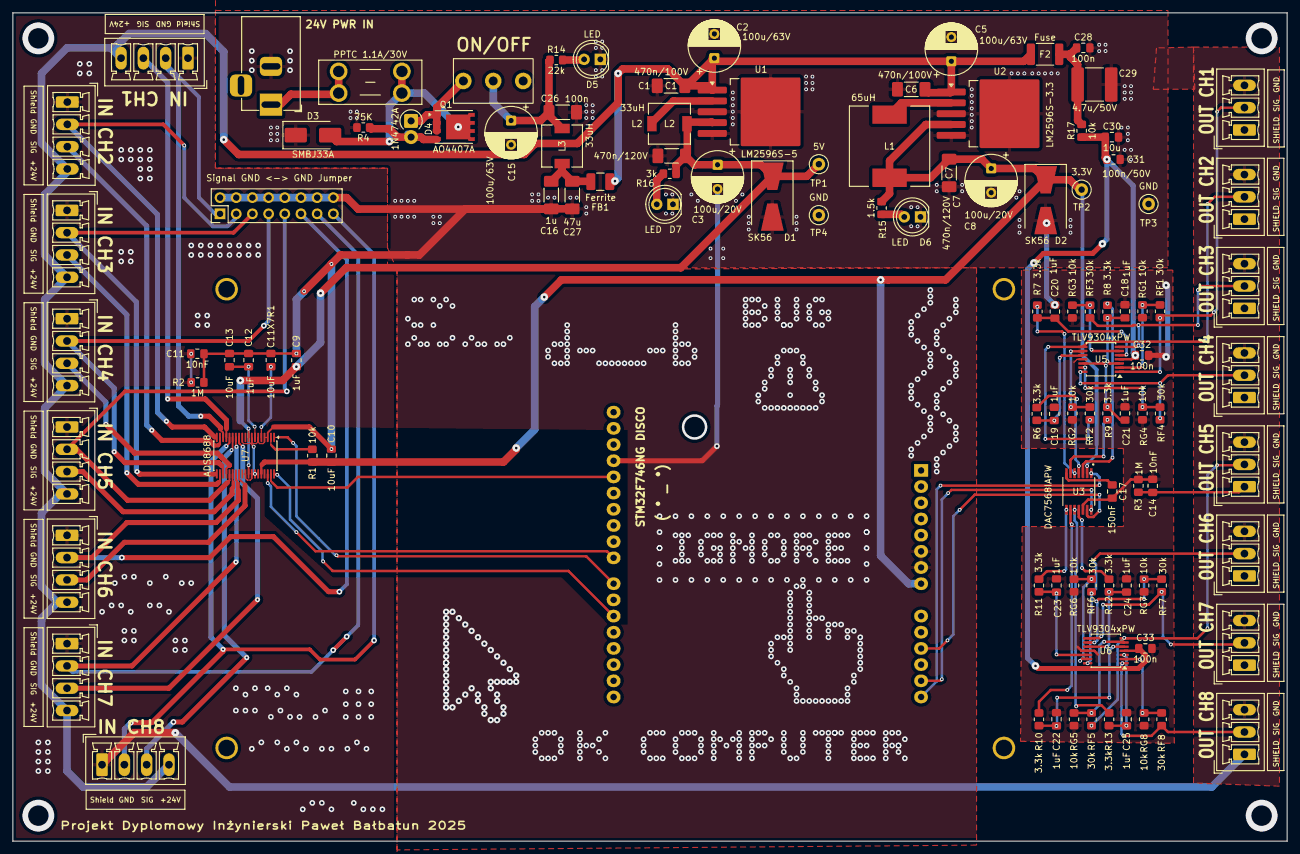
[picture p37: board HVAC_STM32F7_PCB.kicad_pcb from above]

Board: 4 copper layers, 200.0 x 130.0 mm, 110 parts (0 on the bottom side), 77 nets.
