Jopolle/INZYNIERKA/(commit log)

2025-10-14 ADD: c-l-c filter, PMOS controll, inditacor LEDs, JLCPCB technology capabilities TODO: footprint assignment to lacking elements,
    [HVAC_STM32F7_PCB.kicad_pcb, zasilanie.kicad_sch]
2025-10-14 ADD: working first draft compilation of documentation, PCB project playing around
2025-10-14 ADD: PCB design started, power supply, buck converters and input ADC placed
    [HVAC_STM32F7_PCB.kicad_pcb]
2025-10-16 add power and input signal trace
    [HVAC_STM32F7_PCB.kicad_pcb]
2025-10-17 ADD finished pcb traces
    [HVAC_STM32F7_PCB.kicad_pcb]
2025-10-19 add: schematic and pcb pdf to view
2025-10-19 ADD: Wstęp do przeglądu hardware'u, dokładny opis modułu zasilającego
    [HVAC_STM32F7_PCB.kicad_pcb]
2025-10-28 ADD: walka z przestawianiem konektorów wejściowych i wyjściowych, TODO: dokończyć łączenie wejściowego ADC
    [HVAC_STM32F7_PCB.kicad_pcb]
2025-10-29 add: ADC podłączone elegancko, separacja mas sygnałów wejściowych, TODO: DRC
    [HVAC_STM32F7_PCB.kicad_pcb, HVAC_STM32F7_PCB.kicad_sch]
2025-11-03 ADD: poprawki w tekscie pracy, cytowania,
    [HVAC_STM32F7_PCB.csv]
2025-11-06 zabawy z grubościami ścierzek
    [HVAC_STM32F7_PCB.kicad_pcb]
2025-11-06 ADD naprawione DRC, TODO last check, filkscreen text
    [HVAC_STM32F7_PCB.kicad_pcb]
2025-11-07 ADD kosmetyka większości opisów komponenów, TODO: ogarnąć masę zasilania aktywnych czujników
    [HVAC_STM32F7_PCB.kicad_pcb]
2025-11-12 kontynuacja walki z pcb
2025-11-18 ADD Poprawki PCB layout TODO zasilanie toru wyjciowego, podpisy elementow i kosmetyka
    [HVAC_STM32F7_PCB.kicad_pcb, HVAC_STM32F7_PCB.kicad_sch, dac.kicad_sch, zasilanie.kicad_sch]
2025-11-19 ADD final pcb version for review, god bless
    [HVAC_STM32F7_PCB.kicad_pcb, dac.kicad_sch, zasilanie.kicad_sch]
2025-11-26 ADD: działający kontroler z regulatorem PID woooooooo TODO: symulacja on board
2025-11-28 ADD hopefully finished pcb project
    [HVAC_STM32F7_PCB-B_Mask.gbr, HVAC_STM32F7_PCB-B_Paste.gbr, HVAC_STM32F7_PCB-B_Silkscreen.gbr, HVAC_STM32F7_PCB-Back.gbr, HVAC_STM32F7_PCB-Edge_Cuts.gbr, HVAC_STM32F7_PCB-F_Mask.gbr, HVAC_STM32F7_PCB-F_Paste.gbr, HVAC_STM32F7_PCB-F_Silkscreen.gbr]
2025-11-29 ADD: opis części hardware, dodane zdjęcia i schematy
    [HVAC_STM32F7_PCB.kicad_sch, dac.kicad_sch]
2025-12-02 ADD: poprawki pcb, nowe gerbery
    [HVAC_STM32F7_PCB-B_Mask.gbr, HVAC_STM32F7_PCB-B_Paste.gbr, HVAC_STM32F7_PCB-B_Silkscreen.gbr, HVAC_STM32F7_PCB-Back.gbr, HVAC_STM32F7_PCB-Edge_Cuts.gbr, HVAC_STM32F7_PCB-F_Mask.gbr, HVAC_STM32F7_PCB-F_Paste.gbr, HVAC_STM32F7_PCB-F_Silkscreen.gbr]
2025-12-04 ADD: wgranie ikonek, poprawa parsowania konfiguracji, wizualne zmiany dla bajeranckości, TBA: ekran wglądu sekwencji odzysku ciepła, ikonki dla kanałów I/O
    [HVAC_STM32F7_PCB-B_Mask.gbr, HVAC_STM32F7_PCB-B_Paste.gbr, HVAC_STM32F7_PCB-B_Silkscreen.gbr, HVAC_STM32F7_PCB-Back.gbr, HVAC_STM32F7_PCB-Edge_Cuts.gbr, HVAC_STM32F7_PCB-F_Mask.gbr, HVAC_STM32F7_PCB-F_Paste.gbr, HVAC_STM32F7_PCB-F_Silkscreen.gbr]
2025-12-09 ADD: zdjecia GUI, rework sekcji kierunków rozwoju, dodanie opisu tlv, wstowiony render płytki
    [HVAC_STM32F7_PCB.csv, HVAC_STM32F7_PCB.kicad_sch]
2025-12-10 ADD: finalne zmiany, wysyłanie dokumentu do recenzji
    [BOM.csv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]
